vibr77/AppleUnidiskSniffer_stm32f411/hardware/stm32_sniffer/stm32_sniffer.kicad_pcb

## KiCad design hardware/stm32_sniffer/stm32_sniffer.kicad_pcb (2025-03-10)

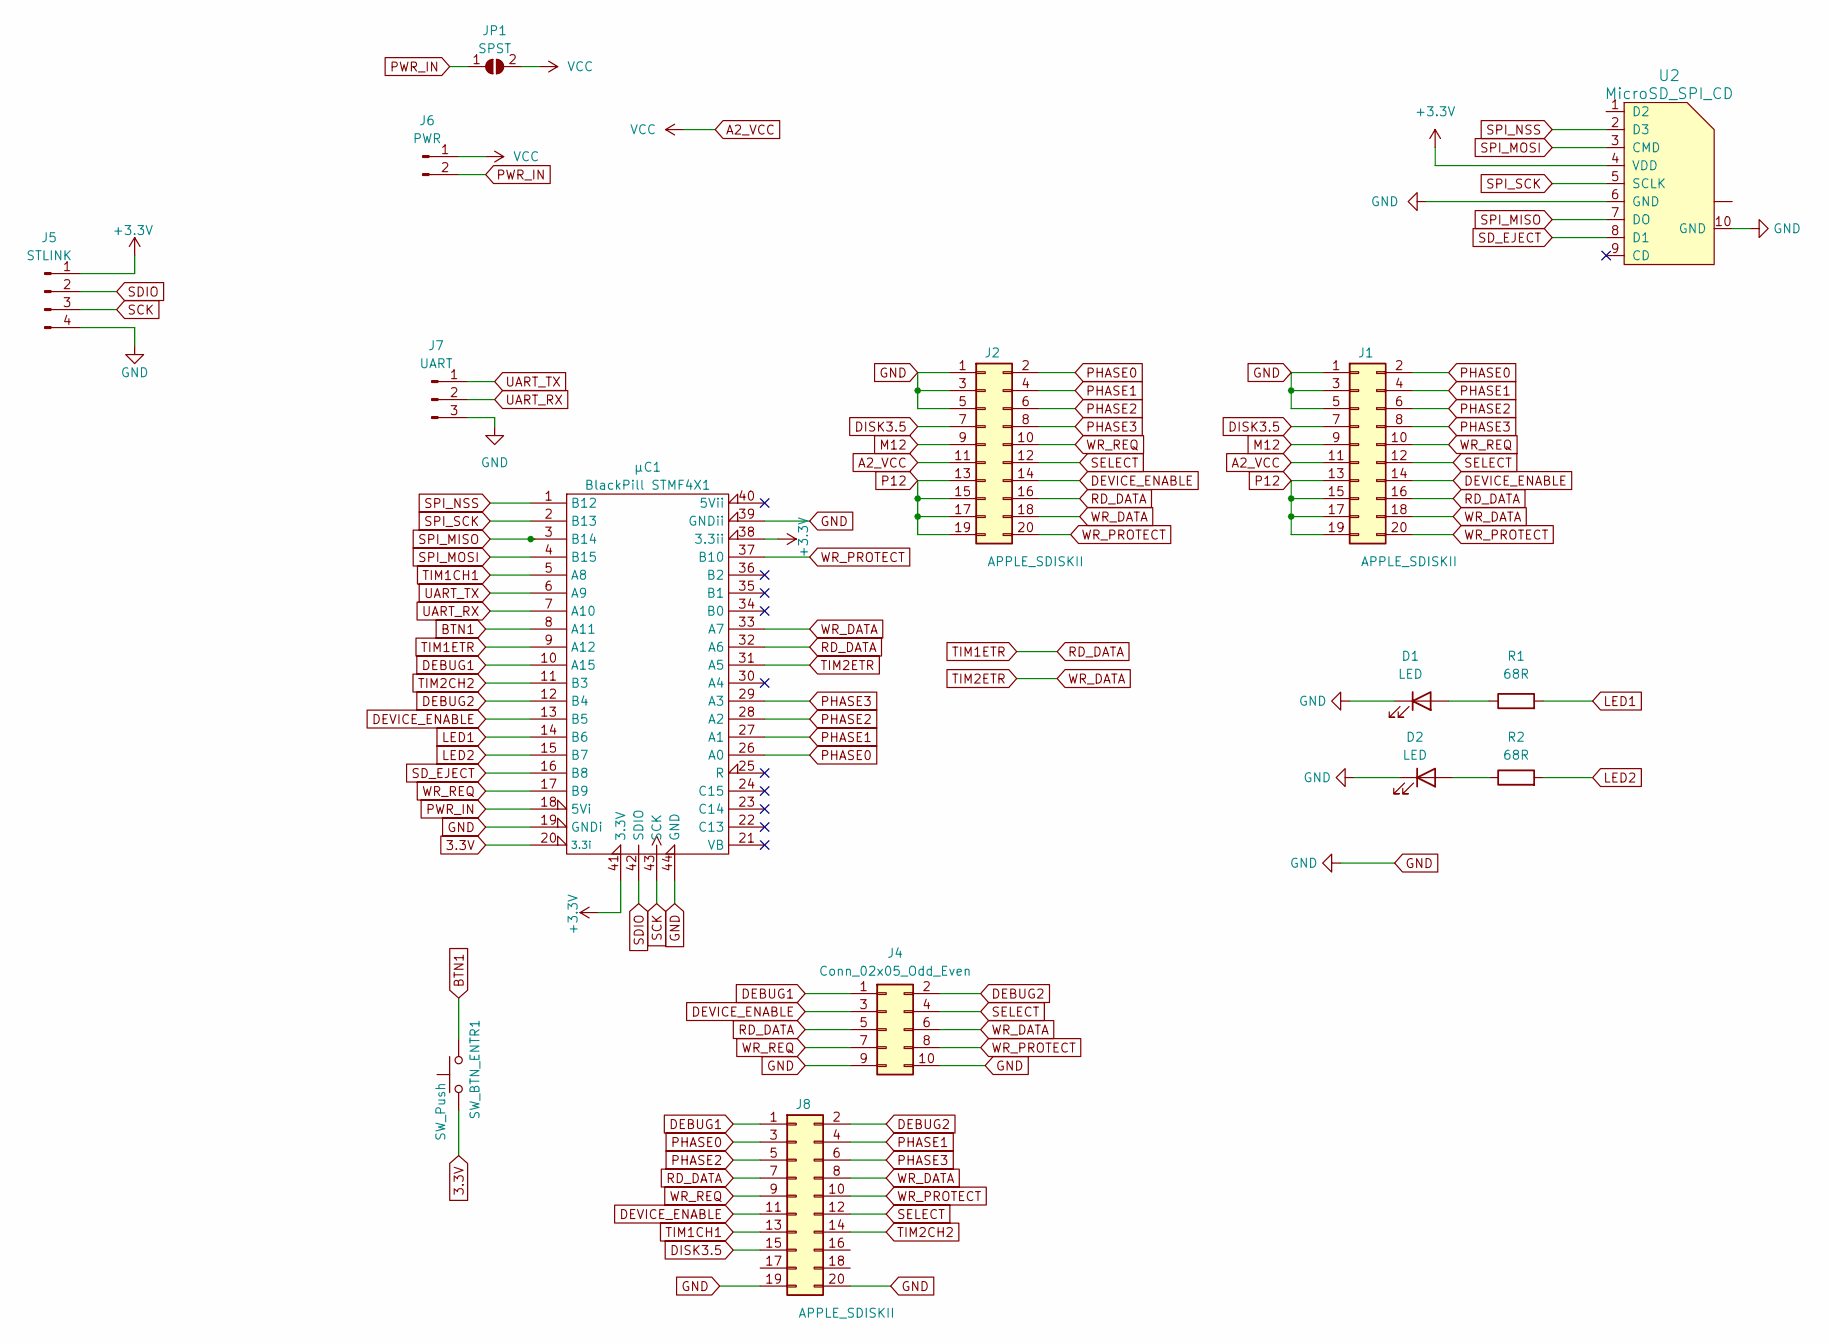
[picture p1: schematic stm32_sniffer.kicad_sch]

Parts:
D1, D2: LED; LED_D5.0mm
J1, J2: APPLE_SDISKII; IDC-Header_2x10_P2.54mm_Vertical
J4: Conn_02x05_Odd_Even; IDC-Header_2x05_P2.54mm_Vertical
J5: STLINK; PinHeader_1x04_P2.54mm_Vertical
J6: PWR; PinHeader_1x02_P2.54mm_Vertical
J7: UART; PinHeader_1x03_P2.54mm_Vertical
J8: APPLE_SDISKII; PinHeader_2x10_P2.54mm_Vertical
JP1: SPST; SolderJumper-2_P1.3mm_Open_RoundedPad1.0x1.5mm
R1, R2: 68R; R_Axial_DIN0207_L6.3mm_D2.5mm_P7.62mm_Horizontal
SW_BTN_ENTR1: SW_Push; SW_PUSH_6mm
U2: MicroSD_SPI_CD; GCT-MEM2055-00-190-01-A
μC1: BlackPill STMF4X1; Mini_F4X1_STM32_VIB

Connections:
3.3V: SW_BTN_ENTR1.1, μC1.20 (3.3i); also elsewhere on the board
+3.3V: J5.1, U2.4 (VDD), μC1.38 (3.3ii), μC1.41 (3.3V)
A2_VCC: J1.11, J2.11, J6.1, JP1.2 (B)
BTN1: SW_BTN_ENTR1.2, μC1.8 (A11); also elsewhere on the board
DEBUG1: J4.1, J8.1, μC1.10 (A15)
DEBUG2: J4.2, J8.2, μC1.12 (B4)
DEVICE_ENABLE: J1.14, J2.14, J4.3, J8.11, μC1.13 (B5)
DISK3.5: J1.7, J2.7, J8.15
GND: D1.1 (K), D2.1 (K), J1.1, J1.3, J1.5, J2.1, J2.3, J2.5, J4.9, J4.10, J5.4, J7.3, J8.19, J8.20, U2.6 (GND), U2.10 (GND), μC1.19 (GNDi), μC1.39 (GNDii), μC1.44 (GND)
LED1: R1.2, μC1.14 (B6)
LED2: R2.2, μC1.15 (B7)
M12: J1.9, J2.9
unnamed: D1.2 (A), R1.1
unnamed: D2.2 (A), R2.1
P12: J1.13, J1.15, J1.17, J1.19, J2.13, J2.15, J2.17, J2.19
PHASE0: J1.2, J2.2, J8.3, μC1.26 (A0)
PHASE1: J1.4, J2.4, J8.4, μC1.27 (A1)
PHASE2: J1.6, J2.6, J8.5, μC1.28 (A2)
PHASE3: J1.8, J2.8, J8.6, μC1.29 (A3)
PWR_IN: J6.2, JP1.1 (A), μC1.18 (5Vi)
RD_DATA: J1.16, J2.16, J4.5, J8.7, μC1.9 (A12), μC1.32 (A6)
SCK: J5.3, μC1.43 (SCK)
SDIO: J5.2, μC1.42 (SDIO)
SD_EJECT: U2.8 (D1), μC1.16 (B8)
SELECT: J1.12, J2.12, J4.4, J8.12
SPI_MISO: U2.7 (DO), μC1.3 (B14)
SPI_MOSI: U2.3 (CMD), μC1.4 (B15)
SPI_NSS: U2.2 (D3), μC1.1 (B12)
SPI_SCK: U2.5 (SCLK), μC1.2 (B13)
TIM1CH1: J8.13, μC1.5 (A8)
TIM2CH2: J8.14, μC1.11 (B3)
TIM2ETR: J1.18, J2.18, J4.6, J8.8, μC1.31 (A5), μC1.33 (A7)
UART_RX: J7.2, μC1.7 (A10)
UART_TX: J7.1, μC1.6 (A9)
WR_PROTECT: J1.20, J2.20, J4.8, J8.10, μC1.37 (B10)
WR_REQ: J1.10, J2.10, J4.7, J8.9, μC1.17 (B9)

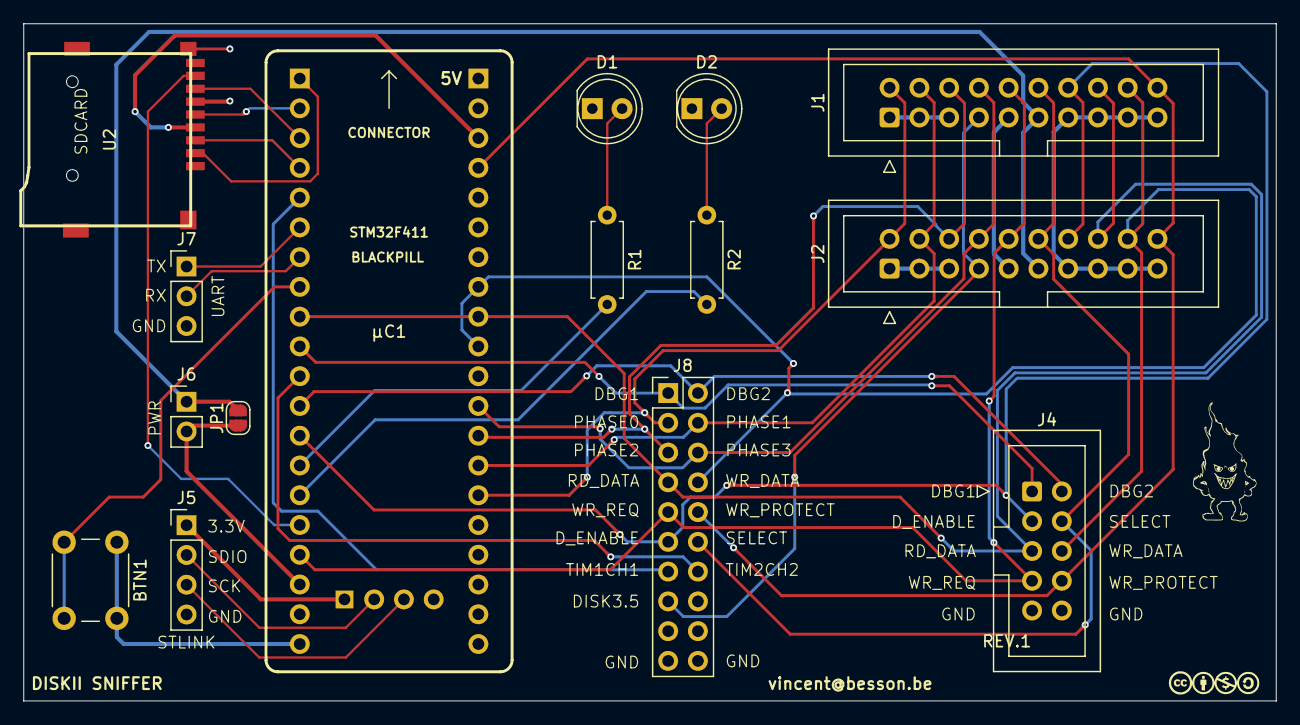
[picture p2: board stm32_sniffer.kicad_pcb from above]

Board: 2 copper layers, 106.9 x 57.8 mm, 16 parts (0 on the bottom side), 36 nets.

Other parts of the board:
 : LOGO
BTN1: SW_Push; SW_PUSH_6mm

Their connections:
3.3V: BTN1.1; also elsewhere on the board
BTN1: BTN1.2; also elsewhere on the board
