vibr77/AppleUnidiskSniffer_stm32f411/Core/Inc/main.h

#define PUTCHAR_PROTOTYPE int __io_putchar(int ch)
#define PUTCHAR_PROTOTYPE int fputc(int ch, FILE *f)
#define PHASE0_Pin GPIO_PIN_0
#define PHASE0_GPIO_Port GPIOA
#define PHASE0_EXTI_IRQn EXTI0_IRQn
#define PHASE1_Pin GPIO_PIN_1
#define PHASE1_GPIO_Port GPIOA
#define PHASE1_EXTI_IRQn EXTI1_IRQn
#define PHASE2_Pin GPIO_PIN_2
#define PHASE2_GPIO_Port GPIOA
#define PHASE2_EXTI_IRQn EXTI2_IRQn
#define PHASE3_Pin GPIO_PIN_3
#define PHASE3_GPIO_Port GPIOA
#define PHASE3_EXTI_IRQn EXTI3_IRQn
#define RD_DATA_Pin GPIO_PIN_6
#define RD_DATA_GPIO_Port GPIOA
#define WR_DATA_Pin GPIO_PIN_7
#define WR_DATA_GPIO_Port GPIOA
#define WR_PROTECT_Pin GPIO_PIN_10
#define WR_PROTECT_GPIO_Port GPIOB
#define WR_PROTECT_EXTI_IRQn EXTI15_10_IRQn
#define DEBUG1_Pin GPIO_PIN_15
#define DEBUG1_GPIO_Port GPIOA
#define DEBUG2_Pin GPIO_PIN_3
#define DEBUG2_GPIO_Port GPIOB
#define DEVICE_ENABLE_Pin GPIO_PIN_5
#define DEVICE_ENABLE_GPIO_Port GPIOB
#define DEVICE_ENABLE_EXTI_IRQn EXTI9_5_IRQn
#define WR_REQ_Pin GPIO_PIN_9
#define WR_REQ_GPIO_Port GPIOB
#define WR_REQ_EXTI_IRQn EXTI9_5_IRQn
